growth-team/GROWTH-FY2015-ADC-VersionB/README.md

#GROWTH-FY2015-ADC-VersionB

Eagle PCB design files of GROWTH-FY2015 ADC Board Version B.

Parts library "Aardvark.lbr" is required to open the schematic and the board files with eagle.
