growth-team/GROWTH-FY2015-ADC-VersionB/P板.com/送り状.pdf

## 板 福島実装サービスセンター 担当：黒井 宛

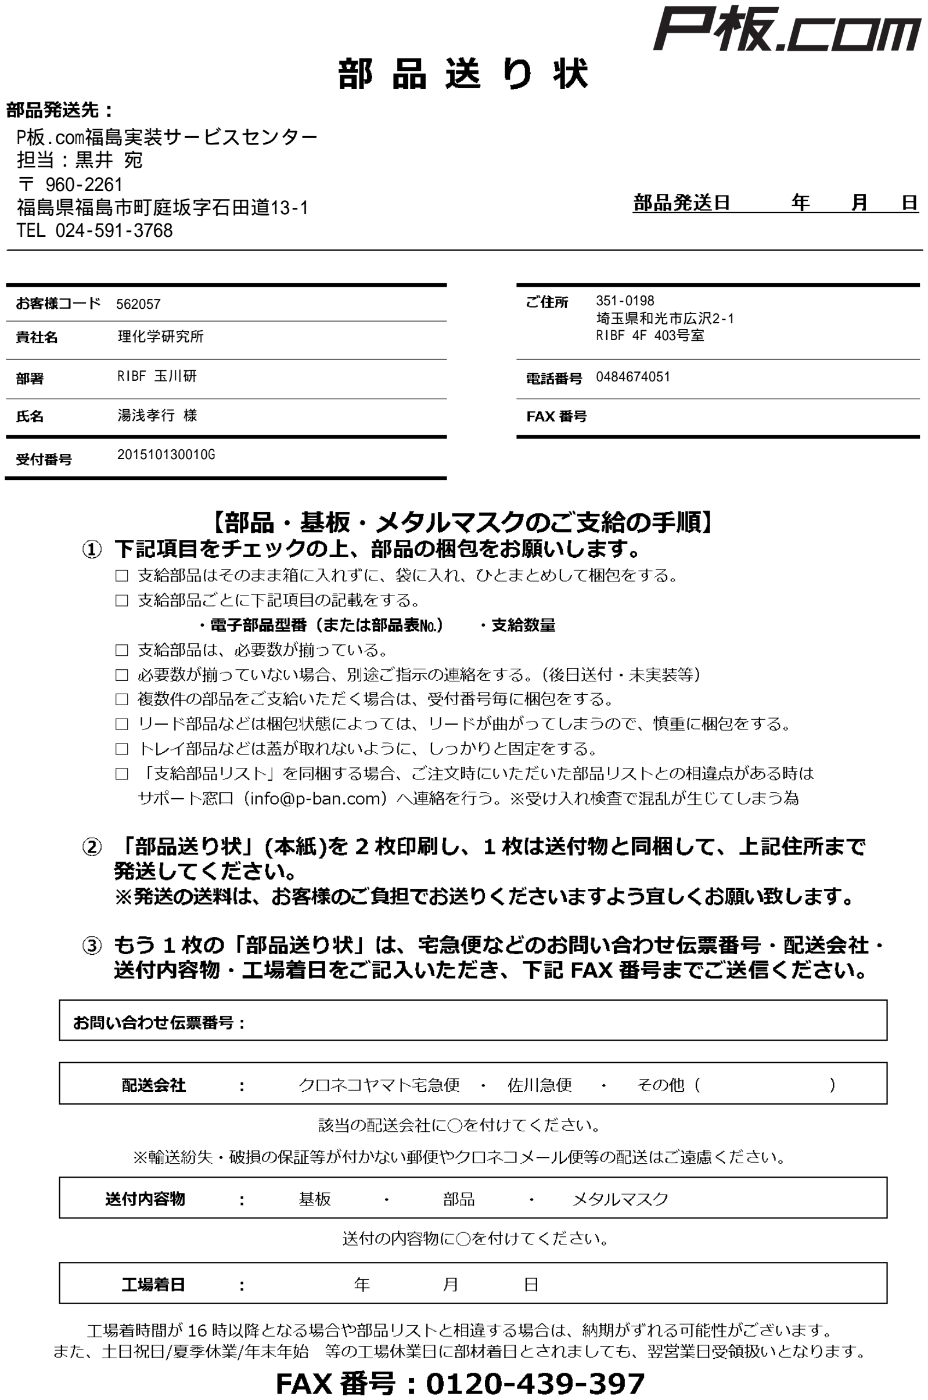
[picture p1: page 1]

〒

## 福島県福島市町庭坂字石田道 TEL 024-591-3768

351-0198 562057 | 埼玉県和光市広沢
理化学研究所 | 号室
玉川研 | 0484674051 湯浅孝行 様

201510130010G

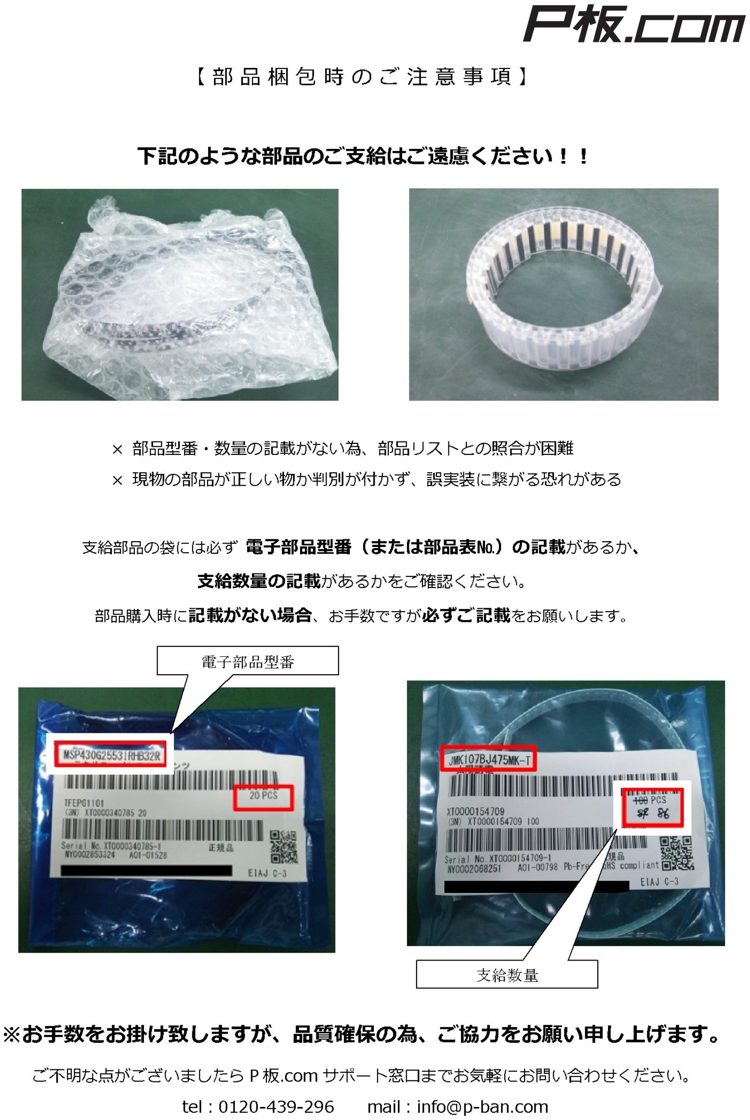
[picture p2: page 2]
