growth-team/GROWTH-FY2015-ADC-VersionB/P板.com/部品パーツリスト_2版.xls

Sheet: 必ずお読みください
入力項目説明
メ ー カ ー |  |  | 電子部品のメーカー名をご入力ください。
部 品 種 別 |  |  | 電子部品の種別をご入力ください。例：チップ抵抗、トランジスタ、LED、など
電 子 部 品 型 番 |  |  | 電子部品の型番をご入力ください。 ※誤表記による不具合を回避するためにも正確なご入力をお願い致します。 ※表面実装の抵抗やコンデンサ(電解、タンタル以外)は、後述「電子部品見取り表」をご参照のうえ、ご入力ください。
配 置 記 号 / リファレンス |  |  | シルク図/配置図に表記された配置記号/リファレンス番号をご入力ください。 ※複数入力する場合は、カンマ「,」区切りでのご入力をお願い致します。 ※電子部品型番ベースでのご記入をお願い致します。（１つの電子部品型番に対して、配置番号を複数記入）
個 数 |  |  | 電子部品の個数をご入力ください。
ピ ン 数 |  |  | 電子部品の総ピン数をご入力ください。 ※基板取付穴、部品取付穴、全てのスルー・ノンスルーホール、面実装部品のパッド、及び次の①～⑤の配線を伴う箇所（①テストピン、②チェックランド、③引き出しランド、④ジャンパピン、⑤入出力ランドの総計。
実装 / 未実装 |  |  | 実装サービスでの「実装」/「未実装」をご選択ください。 ※同じ電子部品型番の中で実装と未実装が分かれる場合は、それぞれ2行に分けて配置記号をご入力ください。
部品分類 | SMD |  | 表面実装部品
 | DIP |  | 挿入部品
 | 特殊 BGA等 |  | BGA/CSP/LGA/QFNなど部品極性が部品の真下に配置された部品 -BGA：Ball Grid Array/下面に半田ボールの端子を配置したパッケージ。 -CSP：Chip Size Package/チッププサイズと同じか、もしくは僅かに大きいパッケージ。 -LGA：Land Grid Array/裏面に外部入出力用のランドを設けたパッケージ。※BGAの半田ボールがない。 -QFN：Quad Flat Non-Lead Package/QFPに似ていますが、外部入出力用のピンが出ていないパッケージ。
P板.com提供部品 (無料) |  |  | P板.com実装サービスで無料提供しているチップ部品が含まれている場合に○をご選択ください。 ※無料提供部品：チップコンデンサ/チップ抵抗を約1500種、実装サービスをご利用のお客様に無料提供いたします。
 |  |  | http://www.p-ban.com/implementation/chip.html
P板.com調達部品(有料） |  |  | P板.com実装サービスで部品調達を希望される場合に○をご選択ください。 ※調達費用のお見積もりは、部品リストの返却と同時にご連絡いたします。 ※ご希望の納期や市場在庫状況によっては、調達が不可となる部品もございますので、予めご了承ください。
パッケージ情報 部品外形/部品仕様 |  |  | 電子部品のパッケージ情報をご入力ください。例：1608 , DIP , 0.5mmピッチQFP , 0.4mmピッチCN
コ メ ン ト |  |  | 特別なご指示のある電子部品について、自由にご入力ください。 例：未実装挿入穴のマスク処理が必要、など
版、変更履歴 |  |  | 部品種毎に、変更履歴を記載してください。 版は、アカウント登録の版に合わせて記載ください。
調達型式、代替型式 |  |  | 無料提供部品の在庫切れや、正確な調達型式を記載いたします。
部品名称見取り表
1.チップ部品（抵抗、コンデンサ）
 |  |  |  |  | 単位：ｍｍ
 |  |  | 電子部品型番 (C:コンデンサ、R:抵抗） | Ａ寸法 | Ｂ寸法
 |  |  | C/R1608 | 1.6 | 0.8
 |  |  | C/R2125 | 2 | 1.25
 |  |  | C/R3216 | 3.2 | 1.6
 |  |  | C/R3225 | 3.2 | 2.5
 |  |  | C/R4532 | 4.5 | 3.2
2.チップタンタルコンデンサ
 |  |  |  |  | 単位：ｍｍ
 |  |  | 電子部品型番 | Ａ寸法 | Ｂ寸法
 |  |  | CT3216 | 3.2 | 1.6
 |  |  | CT3528 | 3.5 | 2.8
 |  |  | CT4726 | 4.7 | 2.6
 |  |  | CT6032 | 6 | 3.2
 |  |  | CT5846 | 5.8 | 4.6
 |  |  | CT7343 | 7.3 | 4.3
3.チップアルミ電解コンデンサ
 |  |  |  |  |  | 単位：ｍｍ
 |  |  | 電子部品型番 | Ａ寸法 | Ｂ寸法 | C寸法
 |  |  | CE33 | 3.3 | 3.3 | φ3.0
 |  |  | CE43 | 4.3 | 4.3 | φ4.0
 |  |  | CE53 | 5.3 | 5.3 | φ5.0
 |  |  | CE66 | 6.6 | 6.6 | φ6.3
 |  |  | CE83 | 8.3 | 8.3 | φ8.0
 |  |  | CE103 | 10.3 | 10.3 | φ10.0
部品取り付け穴は、ピン数に含めてください。
コネクタの場合 |  |  |  |  |  | トランスの場合
部品リストフォーマット変更履歴
2014-02-01 | v2.0 | 松森 | 部品種別の総計を、直接関数に変更
 |  |  | ピン数合計、実装数合計数量を、直接関数に変更
 |  |  | 部品調達見積欄を修正
2014-03-11 | v2.1 | 松森 | *N列、O列が下の方、"○"選択リスト消えていたのを追加
 |  |  | *縮小しても解像度崩れず文字表示するため、フォントを"Meiryo UI"(Windows 標準添付)に変更
 |  |  | *136行目以降を非表示
 |  |  | *"X"列にリストを埋め込み
2014-06-12 | v2.2 | 松森 | *固定行を変更
 |  |  | *在庫状況列に条件付き書式設定
 |  |  | *その他各種バグ修正
2015-03-31 | V2.3 | 松森 | *無償提供部品を記載すると、無償提供部品欄に自動で"○"が表示されるよう条件式を挿入
 |  |  | *併せて、無償提供部品参照用一覧シートの作成・追加
 |  |  | *最小購入数が必要数量を下回る場合、セルを赤色にハッチングする
 |  |  | *シート1の名称変更
 |  |  | *変更履歴シートの追加
2015-06-19 | v2.4 | 松森 | ・ゼロΩ抵抗を無償対象に追加
 |  |  | ・変更履歴の列を追加し、変更履歴シートを削除
 |  |  | ・その他書式、印刷機能の変更
 |  |  | ・無償提供部品の入れ替え
2015-08-14 | v2.5 | 松森 | ・ゼロΩ抵抗の無償対象品が正しく反映されていなかったバグ修正
 |  |  | ・フォームへバージョン情報を埋め込み

Sheet: 部品リスト入力フォーム
Ver.2.5 |  |  | 電 子 部 品 型 番 ※半角英数字 ※サフィックスまで入力必須 | 配 置 記 号 リ フ ァ レ ン ス ※半角英数字） | 個数 | ピ ン 数 (部品取付穴 を含む） |  | 実装/ 未実装 | 部 品 分 類 |  |  | 必要数 実装枚数を入れてください。 ↓ | P板.com 提供 部品 (無料) | P板.com 調達 部品 (有料） | パッケージ情報 部品外形/部品仕様 | コ メ ン ト ※未実装挿入穴のマスク処理が必要、など | 版 変更履歴 | 調達型式、代替型式 |  | 入荷数 | 返却
No | メーカー | 部品種別 |  |  |  | 1個 あたり | 合計 | 実装個数 | SMD | DIP | 特殊 BGA等 |  |  |  |  |  |  | メーカー | 型名 |  |  | 部品調達使用欄
 |  |  |  |  | 170 | 342 | 749 | 170 | 132 | 38 | 0 | 4 | リスト (http://www.p-ban.com/implementation/chip.html)
例 | KOA | チップ抵抗 | RK73B2ATTD1002F | R1,R5,R9,R10 | 4 | 2 | 8 | 未実装 | SMD |  |  |  |  |  | 2012 |  | 4版 型式訂正、個数変更、実装→未実装へ |  |  |  |  | 必要数 | 調達数 | 在庫状況 | 納期
1 □ | 不明 | ピンヘッダ | 1x5ピンヘッダ | JP_SPI | 1 | 5 | 5 | 実装 | DIP | DIP | DIP | 4 | #N/A |  | DIP |  |  |  |  |  | □
2 □ | Lumberg | USB Type Aコネクタ | 2410 01 | J630, J640 | 2 | 6 | 12 | 実装 | DIP | DIP | DIP | 8 | #N/A |  | DIP |  |  |  |  |  | □
3 □ | TOSHIBA | P-ch MOSFET | 2SJ681 | U303, U521 | 2 | 3 | 6 | 実装 | DIP | DIP | DIP | 8 | #N/A |  | 2-7J2B |  |  |  |  |  | □
4 □ | 不明 | ピンソケット | 2x20 ピンソケット | J400 | 1 | 40 | 40 | 実装 | DIP | DIP | DIP | 4 | #N/A |  | DIP |  | 2版でコメント削除。 |  |  |  | □
5 □ | 不明 | ピンソケット | 2x20のピンソケット | J180_CN1, J180_CN2 | 2 | 40 | 80 | 実装 | DIP | DIP | DIP | 8 | #N/A |  | DIP |  |  |  |  |  | □
6 □ | 不明 | ピンヘッダ | 2x2ピンヘッダ | JP_ADC | 1 | 4 | 4 | 実装 | DIP | DIP | DIP | 4 | #N/A |  | DIP |  |  |  |  |  | □
7 □ | 不明 | ピンソケット | 2x7ピンソケット | JP_LCD | 1 | 14 | 14 | 実装 | DIP | DIP | DIP | 4 | #N/A |  | DIP |  |  |  |  |  | □
8 □ | Molex | USB mini Bコネクタ | 54819-0572 | J181, J182 | 2 | 9 | 18 | 実装 | SMD | SMD | SMD | 8 | #N/A |  | SMD |  |  |  |  |  | □
9 □ | Analog Devices | IC | AD8138AARZ | U101, U111, U121, U131 | 4 | 8 | 32 | 実装 | SMD | SMD | SMD | 16 | #N/A |  | SOIC-8 |  |  |  |  |  | □
10 □ | Analog Devices | IC | AD9215BRUZ-65 | U100, U110, U120, U130 | 4 | 28 | 112 | 実装 | SMD | SMD | SMD | 16 | #N/A |  | TSSOP-28 |  |  |  |  |  | □
11 □ | LEMO | 同軸コネクタ | EPL.00.250.NTN | J100, J110, J120, J130 | 4 | 5 | 20 | 実装 | DIP | DIP | DIP | 16 | #N/A |  | DIP |  |  |  |  |  | □
12 □ | Future Technology | IC | FT232RL | IC100 | 1 | 28 | 28 | 実装 | SMD | SMD | SMD | 4 | #N/A |  | SSOP28 |  |  |  |  |  | □
13 □ | Future Technology | IC | FT245RL | IC101 | 1 | 28 | 28 | 実装 | SMD | SMD | SMD | 4 | #N/A |  | SSOP28 |  |  |  |  |  | □
14 □ | MURATA | チップコンデンサ | GRM188B11H103K | C197 | 1 | 2 | 2 | 実装 | SMD | SMD | SMD | 4 | #NAME? |  | 1608 |  |  |  |  |  | □
15 □ | MURATA | チップコンデンサ | GRM2162C1H101J | C100, C110 | 2 | 2 | 4 | 実装 | SMD | SMD | SMD | 8 | #NAME? |  | 2012 |  |  |  |  |  | □
16 □ | MURATA | チップコンデンサ | GRM2162C1H201J | C101, C111 | 2 | 2 | 4 | 実装 | SMD | SMD | SMD | 8 | #NAME? |  | 2012 |  |  |  |  |  | □
17 □ | MURATA | チップコンデンサ | GRM219B11H333K | C102, C103, C112, C113 | 4 | 2 | 8 | 実装 | SMD | SMD | SMD | 16 | #NAME? |  | 2012 |  |  |  |  |  | □
18 □ | MURATA | チップコンデンサ | GRM21BB10J106K | C105, C109, C115, C119, C125, C129, C135, C139 | 8 | 2 | 16 | 実装 | SMD | SMD | SMD | 32 | #NAME? |  | 2012 |  |  |  |  |  | □
19 □ | MURATA | チップコンデンサ | GRM21BB11E104K | C104, C106, C107, C108, C114, C116, C117, C118, C124, C126, C127, C128, C134, C136, C137, C138, C190, C192, C193, C195 | 20 | 2 | 40 | 実装 | SMD | SMD | SMD | 80 | #NAME? |  | 2012 |  |  |  |  |  | □
20 □ | MURATA | チップコンデンサ | GRM21BB31E475K | C191, C194 | 2 | 2 | 4 | 実装 | SMD | SMD | SMD | 8 | #NAME? |  | 2012 |  |  |  |  |  | □
21 □ | MURATA | チップコンデンサ | GRM31CB11A106K | C198, C411, C601, C611, C620, C621, C623, C624 | 8 | 2 | 16 | 実装 | SMD | SMD | SMD | 32 | #NAME? |  | 3216 |  |  |  |  |  | □
22 □ | MURATA | チップコンデンサ | GRM31MB11C105K | C410, C622, C625 | 3 | 2 | 6 | 実装 | SMD | SMD | SMD | 12 | #NAME? |  | 3216 |  |  |  |  |  | □
23 □ | JAE | コネクタ | IL-G-2P-S3T2-SA | J121, J131, J620 | 3 | 2 | 6 | 実装 | DIP | DIP | DIP | 12 | #N/A |  | DIP |  |  |  |  |  | □
24 □ | JAE | コネクタ | IL-G-3P-S3T2-SA | J410, J411, J_UART | 3 | 3 | 9 | 実装 | DIP | DIP | DIP | 12 | #N/A |  | DIP |  |  |  |  |  | □
25 □ | JAE | コネクタ | IL-G-4P-S3T2-SA | J600_12V, J650_VOUT, J_I2C | 3 | 4 | 12 | 実装 | DIP | DIP | DIP | 12 | #N/A |  | DIP |  |  |  |  |  | □
26 □ | Fairchild Semiconductor | トランジスタ | KSP2222ABU | U302, U520 | 2 | 3 | 6 | 実装 | DIP | DIP | DIP | 8 | #N/A |  | TO-92 |  |  |  |  |  | □
27 □ | RSコンポーネンツ | DC電源ソケット | LD-0202-2.0 | J610 | 1 | 3 | 3 | 実装 | DIP | DIP | DIP | 4 | #N/A |  | DIP |  |  |  |  |  | □
28 □ | Texas Instruments | 温度センサ | LM60CIZ/NOPB | U413 | 1 | 3 | 3 | 実装 | DIP | DIP | DIP | 4 | #N/A |  | TO-92 |  |  |  |  |  | □
29 □ | Texas Instruments | IC | LM6172IM/NOPB | U102, U112 | 2 | 8 | 16 | 実装 | SMD | SMD | SMD | 8 | #N/A |  | SOP-8 |  |  |  |  |  | □
30 □ | Linear Technology | IC | LT6106HS5#TRMPBF | U500, U510 | 2 | 5 | 10 | 実装 | SMD | SMD | SMD | 8 | #N/A |  | TSOT-5 |  |  |  |  |  | □
31 □ | Linear Technology | IC | LTC1983ES6-3#TRMPBF | U620 | 1 | 6 | 6 | 実装 | SMD | SMD | SMD | 4 | #N/A |  | SMD |  |  |  |  |  | □
32 □ | Linear Technology | IC | LTC1983ES6-5#TRMPBF | U621 | 1 | 6 | 6 | 実装 | SMD | SMD | SMD | 4 | #N/A |  | SMD |  |  |  |  |  | □
33 □ | Vishay | 抵抗 | LVR03R0100FE12 | R500, R510 | 2 | 2 | 4 | 実装 | DIP | DIP | DIP | 8 | #N/A |  | DIP |  |  |  |  |  | □
34 □ | Microchip | IC | MCP1525T-I/TT | U411 | 1 | 3 | 3 | 実装 | SMD | SMD | SMD | 4 | #N/A |  | TSOT-23-3 |  |  |  |  |  | □
35 □ | Microchip | IC | MCP3208-CI/SL | U410 | 1 | 16 | 16 | 実装 | SMD | SMD | SMD | 4 | #N/A |  | SOIC-16 |  |  |  |  |  | □
36 □ | Texas Instruments | DCDC電源モジュール | PTH12050WAH | U600, U610 | 2 | 6 | 12 | 実装 | DIP | DIP | DIP | 8 | #N/A |  | DIP |  |  |  |  |  | □
37 □ | KOA | チップ抵抗 | RK73B2ATTD202J | R192, R610 | 2 | 2 | 4 | 実装 | SMD | SMD | SMD | 8 | #NAME? |  | 2012 |  |  |  |  |  | □
38 □ | KOA | チップ抵抗 | RK73B2ATTD302J | R190 | 1 | 2 | 2 | 実装 | SMD | SMD | SMD | 4 | #NAME? |  | 2012 |  |  |  |  |  | □
39 □ | KOA | チップ抵抗 | RK73B2ATTD473J | R300, R520 | 2 | 2 | 4 | 実装 | SMD | SMD | SMD | 8 | #NAME? |  | 2012 |  |  |  |  |  | □
40 □ | KOA | チップ抵抗 | RK73B2ATTD563J | R_PZC0, R_PZC1 | 2 | 2 | 4 | 実装 | SMD | SMD | SMD | 8 | #NAME? |  | 2012 |  |  |  |  |  | □
41 □ | KOA | チップ抵抗 | RK73H2ATTD1000F | R501, R511 | 2 | 2 | 4 | 実装 | SMD | SMD | SMD | 8 | #NAME? |  | 2012 |  |  |  |  |  | □
42 □ | KOA | チップ抵抗 | RK73H2ATTD1001F | R191, R193 | 2 | 2 | 4 | 実装 | SMD | SMD | SMD | 8 | #NAME? |  | 2012 |  |  |  |  |  | □
43 □ | KOA | チップ抵抗 | RK73H2ATTD1002F | R108, R118, R502, R512 | 4 | 2 | 8 | 実装 | SMD | SMD | SMD | 16 | #NAME? |  | 2012 |  |  |  |  |  | □
44 □ | KOA | チップ抵抗 | RK73H2ATTD1003F | R107, R117 | 2 | 2 | 4 | 実装 | SMD | SMD | SMD | 8 | #NAME? |  | 2012 |  |  |  |  |  | □
45 □ | KOA | チップ抵抗 | RK73H2ATTD1501F | R523, R601 | 2 | 2 | 4 | 実装 | SMD | SMD | SMD | 8 | #NAME? |  | 2012 |  |  |  |  |  | □
46 □ | KOA | チップ抵抗 | RK73H2ATTD2700F | R600 | 1 | 2 | 2 | 実装 | SMD | SMD | SMD | 4 | #NAME? |  | 2012 |  |  |  |  |  | □
47 □ | KOA | チップ抵抗 | RK73H2ATTD3300F | R197, R198 | 2 | 2 | 4 | 実装 | SMD | SMD | SMD | 8 | #NAME? |  | 2012 |  |  |  |  |  | □
48 □ | KOA | チップ抵抗 | RK73H2ATTD4701F | R301, R302, R303, R521, R522 | 5 | 2 | 10 | 実装 | SMD | SMD | SMD | 20 | #NAME? |  | 2012 |  |  |  |  |  | □
49 □ | KOA | チップ抵抗 | RK73H2ATTD5100F | R101, R102, R103, R104, R111, R112, R113, R114, R121, R122, R123, R124, R131, R132, R133, R134 | 16 | 2 | 32 | 実装 | SMD | SMD | SMD | 64 | #NAME? |  | 2012 |  |  |  |  |  | □
50 □ | KOA | チップ抵抗 | RK73H2ATTD51R0F | R100, R105, R106, R109, R110, R115, R116, R119, R120, R125, R126, R130, R135, R136 | 14 | 2 | 28 | 実装 | SMD | SMD | SMD | 56 | #NAME? |  | 2012 |  |  |  |  |  | □
51 □ | KOA | チップ抵抗 | RK73H2ATTD6800F | R400 | 1 | 2 | 2 | 実装 | SMD | SMD | SMD | 4 | #NAME? |  | 2012 |  |  |  |  |  | □
52 □ | ROHM | チップLED | SML-311WTT86 | LED_5V, LED_5V_SW, LED_HV, LED_RPI | 4 | 2 | 8 | 実装 | SMD | SMD | SMD | 16 | #N/A |  | 1608 |  |  |  |  |  | □
53 □ | Vishay | 可変抵抗 | T93YA502KT20 | VR100, VR110, VR300, VR301, VR_CONT | 5 | 2 | 10 | 実装 | DIP | DIP | DIP | 20 | #N/A |  | DIP |  |  |  |  |  | □
54 □ | Nichicon | 電解コンデンサ | UVR1V101MED | C600, C610 | 2 | 2 | 4 | 実装 | DIP | DIP | DIP | 8 | #N/A |  | DIP |  |  |  |  |  | □
55 □ |  |  |  |  |  |  |  |  |  |  |  |  |  |  |  |  |  |  |  |  | □
56 □ |  |  |  |  |  |  |  |  |  |  |  |  |  |  |  |  |  |  |  |  | □
57 □ |  |  |  |  |  |  |  |  |  |  |  |  |  |  |  |  |  |  |  |  | □
58 □ |  |  |  |  |  |  |  |  |  |  |  |  |  |  |  |  |  |  |  |  | □
59 □ |  |  |  |  |  |  |  |  |  |  |  |  |  |  |  |  |  |  |  |  | □
60 □ |  |  |  |  |  |  |  |  |  |  |  |  |  |  |  |  |  |  |  |  | □
61 □ |  |  |  |  |  |  |  |  |  |  |  |  |  |  |  |  |  |  |  |  | □
62 □ |  |  |  |  |  |  |  |  |  |  |  |  |  |  |  |  |  |  |  |  | □
63 □ |  |  |  |  |  |  |  |  |  |  |  |  |  |  |  |  |  |  |  |  | □
64 □ |  |  |  |  |  |  |  |  |  |  |  |  |  |  |  |  |  |  |  |  | □
65 □ |  |  |  |  |  |  |  |  |  |  |  |  |  |  |  |  |  |  |  |  | □
66 □ |  |  |  |  |  |  |  |  |  |  |  |  |  |  |  |  |  |  |  |  | □
67 □ |  |  |  |  |  |  |  |  |  |  |  |  |  |  |  |  |  |  |  |  | □
68 □ |  |  |  |  |  |  |  |  |  |  |  |  |  |  |  |  |  |  |  |  | □
69 □ |  |  |  |  |  |  |  |  |  |  |  |  |  |  |  |  |  |  |  |  | □
70 □ |  |  |  |  |  |  |  |  |  |  |  |  |  |  |  |  |  |  |  |  | □
71 □ |  |  |  |  |  |  |  |  |  |  |  |  |  |  |  |  |  |  |  |  | □
72 □ |  |  |  |  |  |  |  |  |  |  |  |  |  |  |  |  |  |  |  |  | □
73 □ |  |  |  |  |  |  |  |  |  |  |  |  |  |  |  |  |  |  |  |  | □
74 □ |  |  |  |  |  |  |  |  |  |  |  |  |  |  |  |  |  |  |  |  | □
75 □ |  |  |  |  |  |  |  |  |  |  |  |  |  |  |  |  |  |  |  |  | □
76 □ |  |  |  |  |  |  |  |  |  |  |  |  |  |  |  |  |  |  |  |  | □
77 □ |  |  |  |  |  |  |  |  |  |  |  |  |  |  |  |  |  |  |  |  | □
78 □ |  |  |  |  |  |  |  |  |  |  |  |  |  |  |  |  |  |  |  |  | □
79 □ |  |  |  |  |  |  |  |  |  |  |  |  |  |  |  |  |  |  |  |  | □
80 □ |  |  |  |  |  |  |  |  |  |  |  |  |  |  |  |  |  |  |  |  | □
81 □ |  |  |  |  |  |  |  |  |  |  |  |  |  |  |  |  |  |  |  |  | □
82 □ |  |  |  |  |  |  |  |  |  |  |  |  |  |  |  |  |  |  |  |  | □
83 □ |  |  |  |  |  |  |  |  |  |  |  |  |  |  |  |  |  |  |  |  | □
84 □ |  |  |  |  |  |  |  |  |  |  |  |  |  |  |  |  |  |  |  |  | □
85 □ |  |  |  |  |  |  |  |  |  |  |  |  |  |  |  |  |  |  |  |  | □
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
145 □ |  |  |  |  |  |  |  |  |  |  |  |  |  |  |  |  |  |  |  |  | □
146 □ |  |  |  |  |  |  |  |  |  |  |  |  |  |  |  |  |  |  |  |  | □
147 □ |  |  |  |  |  |  |  |  |  |  |  |  |  |  |  |  |  |  |  |  | □
148 □ |  |  |  |  |  |  |  |  |  |  |  |  |  |  |  |  |  |  |  |  | □

Sheet: 無償提供部品一覧
このシートの内容は変更しないでください。
メーカー型番 |  | メーカー | サイズ | 定数 | 許容差 | 定格
RK73Z1ETTP | ○ | KOA | 1005 | 0
RK73H1ETTP1R00F | ○ | KOA | 1005 | 1 | +/-1% | 0.063W
RK73B1ETTP1R0J | ○ | KOA | 1005 | 1 | +/-5% | 0.063W
RK73H1ETTP1R10F | ○ | KOA | 1005 | 1.1 | +/-1% | 0.063W
RK73B1ETTP1R1J | ○ | KOA | 1005 | 1.1 | +/-5% | 0.063W
RK73H1ETTP1R20F | ○ | KOA | 1005 | 1.2 | +/-1% | 0.063W
RK73B1ETTP1R2J | ○ | KOA | 1005 | 1.2 | +/-5% | 0.063W
RK73H1ETTP1R30F | ○ | KOA | 1005 | 1.3 | +/-1% | 0.063W
RK73B1ETTP1R3J | ○ | KOA | 1005 | 1.3 | +/-5% | 0.063W
RK73H1ETTP1R50F | ○ | KOA | 1005 | 1.5 | +/-1% | 0.063W
RK73B1ETTP1R5J | ○ | KOA | 1005 | 1.5 | +/-5% | 0.063W
RK73H1ETTP1R60F | ○ | KOA | 1005 | 1.6 | +/-1% | 0.063W
RK73B1ETTP1R6J | ○ | KOA | 1005 | 1.6 | +/-5% | 0.063W
RK73H1ETTP1R80F | ○ | KOA | 1005 | 1.8 | +/-1% | 0.063W
RK73B1ETTP1R8J | ○ | KOA | 1005 | 1.8 | +/-5% | 0.063W
RK73H1ETTP2R00F | ○ | KOA | 1005 | 2 | +/-1% | 0.063W
RK73B1ETTP2R0J | ○ | KOA | 1005 | 2 | +/-5% | 0.063W
RK73H1ETTP2R20F | ○ | KOA | 1005 | 2.2 | +/-1% | 0.063W
RK73B1ETTP2R2J | ○ | KOA | 1005 | 2.2 | +/-5% | 0.063W
RK73H1ETTP2R40F | ○ | KOA | 1005 | 2.4 | +/-1% | 0.063W
RK73B1ETTP2R4J | ○ | KOA | 1005 | 2.4 | +/-5% | 0.063W
RK73H1ETTP2R70F | ○ | KOA | 1005 | 2.7 | +/-1% | 0.063W
RK73B1ETTP2R7J | ○ | KOA | 1005 | 2.7 | +/-5% | 0.063W
RK73H1ETTP3R00F | ○ | KOA | 1005 | 3 | +/-1% | 0.063W
RK73B1ETTP3R0J | ○ | KOA | 1005 | 3 | +/-5% | 0.063W
RK73H1ETTP3R30F | ○ | KOA | 1005 | 3.3 | +/-1% | 0.063W
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
GRM188F11C154Z | ○ | MURATA | 1608 | 0.15uF | ＋80%, －20% | DC16V
GRM188B11A224K | ○ | MURATA | 1608 | 0.22uF | ±10% | DC10V
GRM188F11C224Z | ○ | MURATA | 1608 | 0.22uF | ＋80%, －20% | DC16V
GRM188B11A334K | ○ | MURATA | 1608 | 0.33uF | ±10% | DC10V
GRM188F11C334Z | ○ | MURATA | 1608 | 0.33uF | ＋80%, －20% | DC16V
GRM188B11A474K | ○ | MURATA | 1608 | 0.47uF | ±10% | DC10V
GRM188F11C474Z | ○ | MURATA | 1608 | 0.47uF | ＋80%, －20% | DC16V
GRM188F11A684Z | ○ | MURATA | 1608 | 0.68uF | ＋80%, －20% | DC10V
GRM188B11A105K | ○ | MURATA | 1608 | 1uF | ±10% | DC10V
GRM188F11A105Z | ○ | MURATA | 1608 | 1uF | ＋80%, －20% | DC10V
GRM188B31E105K | ○ | MURATA | 1608 | 1uF | ±10% | DC25V
GRM188B10J225K | ○ | MURATA | 1608 | 2.2uF | ±10% | DC6.3V
GRM2162C1H101J | ○ | MURATA | 2012 | 100pF | ±5% | DC50V
GRM2162C1H151J | ○ | MURATA | 2012 | 150pF | ±5% | DC50V
GRM2162C1H201J | ○ | MURATA | 2012 | 200pF | ±5% | DC50V
GRM2162C1H471J | ○ | MURATA | 2012 | 470pF | ±5% | DC50V
GRM2192C1H821J | ○ | MURATA | 2012 | 820pF | ±5% | DC50V
GRM2162C1H102J | ○ | MURATA | 2012 | 1000pF | ±5% | DC50V
GRM2162C1H222J | ○ | MURATA | 2012 | 2200pF | ±5% | DC50V
GRM2162B1H332K | ○ | MURATA | 2012 | 3300pF | ±10% | DC50V
GRM2162C1H332J | ○ | MURATA | 2012 | 3300pF | ±5% | DC50V
GRM219B11H333K | ○ | MURATA | 2012 | 0.033uF | ±10% | DC50V
GRM21BB11E104K | ○ | MURATA | 2012 | 0.1uF | ±10% | DC25V
GRM219F11H104Z | ○ | MURATA | 2012 | 0.1uF | ＋80%, －20% | DC50V
GRM2162F11E154Z | ○ | MURATA | 2012 | 0.15uF | ＋80%, －20% | DC25V
GRM21BF11E334Z | ○ | MURATA | 2012 | 0.33uF | ＋80%, －20% | DC25V
GRM219B11C474K | ○ | MURATA | 2012 | 0.47uF | ±10% | DC16V
GRM21BB11C105K | ○ | MURATA | 2012 | 1uF | ±10% | DC16V
GRM219F11C105Z | ○ | MURATA | 2012 | 1uF | ＋80%, －20% | DC16V
GRM21BB11A225K | ○ | MURATA | 2012 | 2.2uF | ±10% | DC10V
GRM21BB31E475K | ○ | MURATA | 2012 | 4.7uF | ±10% | DC25V
GRM21BB10J106K | ○ | MURATA | 2012 | 10uF | ±10% | DC6.3V
GRM21BB31A106K | ○ | MURATA | 2012 | 10uF | ±10% | DC10V
GRM21BB30J226M | ○ | MURATA | 2012 | 22uF | ±20% | DC6.3V
GRM319R11H104K | ○ | MURATA | 3216 | 0.1uF | ±10% | DC50V
GRM319B11H104K | ○ | MURATA | 3216 | 0.1uF | ±10% | DC50V
GRM319R72A104K | ○ | MURATA | 3216 | 0.1uF | ±10% | DC100V
GRM319R71H104K | ○ | MURATA | 3216 | 0.1uF | ±10% | DC50V
GRM319F11H104Z | ○ | MURATA | 3216 | 0.1uF | ＋80%, －20% | DC50V
GRM31MB11H224K | ○ | MURATA | 3216 | 0.22uF | ±10% | DC50V
GRM319B11C474K | ○ | MURATA | 3216 | 0.47uF | ±10% | DC16V
GRM31MB11C105K | ○ | MURATA | 3216 | 1uF | ±10% | DC16V
GRM31MB11E105K | ○ | MURATA | 3216 | 1uF | ±10% | DC25V
GRM31MB31H105K | ○ | MURATA | 3216 | 1uF | ±10% | DC50V
GRM31MF11E225Z | ○ | MURATA | 3216 | 2.2uF | ＋80%, －20% | DC25V
GRM31MB11C225K | ○ | MURATA | 3216 | 2.2uF | ±10% | DC16V
GRM31MF11C475Z | ○ | MURATA | 3216 | 4.7uF | ＋80%, －20% | DC16V
GRM31CB11A106K | ○ | MURATA | 3216 | 10uF | ±10% | DC10V
GRM31CF11E106Z | ○ | MURATA | 3216 | 10uF | ±10% | DC25V
GRM32RB11H105K | ○ | MURATA | 3225 | 1uF | ±10% | DC50V
GRM32NF11E106Z | ○ | MURATA | 3225 | 10uF | ＋80%, －20% | DC25V
GRM32EB11A106K | ○ | MURATA | 3225 | 10uF | ±10% | DC10V
