growth-team/GROWTH-FY2015-ADC-VersionB/部品調達/output_rs.ods

#部品種類 | メーカー型番 | メーカー | 個数 | 製造に 必要な数 | 理研 在庫数 | 要発注 | RS型番 | RS単価 | RS購入単位 | 1枚あたりの金額
電解コンデンサ | UVR1V101MED | Nichicon | 2 | 8 | 8 | 0 |  |  | 5 | 0
USB Type Aコネクタ | 2410 01 | Lumberg | 2 | 8 | 0 | 8 | 737-8782 | 109 | 1 | 218
トランジスタ | KSP2222ABU | Fairchild | 2 | 8 | 0 | 8 | 739-0385 | 27.4 | 10 | 54.8
P-ch MOSFET | 2SJ681 | TOSHIBA | 2 | 8 | 0 | 8 | 362-812 | 165.0 | 5 | 330
USB mini Bコネクタ | 54819-0572 | Molex | 2 | 8 | 4 | 4 | 515-1995 | 124.0 | 5 | 248
IC | AD8138AARZ | Analog Devices | 4 | 16 | 2 | 14 | 820-8990 | 600.0 | 2 | 2400
IC | AD9215BRUZ-65 | Analog Devices | 4 | 16 | 0 | 16 | 538-6371 | 1461.0 | 1 | 5844
同軸コネクタ | EPL.00.250.NTN | LEMO | 4 | 16 | 8 | 8 | 124-8635 | 2260.0 | 1 | 9040
IC | FT232RL | Future Technology | 1 | 4 | 0 | 4 | 888-8732 | 397.0 | 1 | 397
IC | FT245RL | Future Technology | 1 | 4 | 0 | 4 | 406-540 | 508.0 | 1 | 508
コネクタ | IL-G-2P-S3T2-SA | JAE | 5 | 20 | 4 | 16 | 490-6508 | 30.0 |  | 150
コネクタ | IL-G-3P-S3T2-SA | JAE | 3 | 12 | 0 | 12 | 490-6514 | 30.0 |  | 90
コネクタ | IL-G-4P-S3T2-SA | JAE | 3 | 12 | 12 | 0 | 490-6520 | 30.0 |  | 90
DC電源ソケット | LD-0202-2.0 | RSコンポーネンツ | 1 | 4 | 4 | 0 | 448-382 | 77.0 | 10 | 77
温度センサ | LM60CIZ/NOPB | Texas Instruments | 2 | 8 | 3 | 5 | 761-6003 | 92.8 | 5 | 185.6
IC | LM6172IM/NOPB | Texas Instruments | 2 | 8 | 0 | 8 | 534-3627 | 500.0 | 1 | 1000
IC | LT6106HS5#TRMPBF | Linear Technology | 2 | 8 | 3 | 5 | 786-9727 | 378.2 | 5 | 756.4
IC | LTC1983ES6-3#TRMPBF | Linear Technology | 1 | 4 | 0 | 4 | 858-0876 | 368.5 | 2 | 368.5
IC | LTC1983ES6-5#TRMPBF | Linear Technology | 1 | 4 | 0 | 4 | 761-9276 | 709.0 | 1 | 709
抵抗 | LVR03R0100FE12 | Vishay | 2 | 8 | 6 | 2 | 683-6212 | 107.0 | 5 | 214
IC | MCP1525T-I/TT | Microchip | 1 | 4 | 0 | 4 | 698-9069 | 121.0 | 1 | 121
IC | MCP3208-CI/SL | Microchip | 1 | 4 | 4 | 0 | 379-2522 | 550.0 | 5 | 550
DCDC電源モジュール | PTH12050WAH | Texas Instruments | 2 | 8 | 0 | 8 | 660-6392 | 1784.0 | 1 | 3568
チップLED | SML-311WTT86 | ROHM | 4 | 16 | 0 | 16 | 752-6789 | 11.5 | 10 | 46
可変抵抗 | T93YA502KT20 | Vishay | 5 | 20 | 5 | 15 | 788-5079 | 182.0 | 5 | 910
GPSモジュール | FGPMMOPA6H | GlobalTop | 1 | 4 | 2 | 2 |  | 3500.0 |  | 3500
ピンヘッダ | 1x5ピンヘッダ | 不明 | 1 | 4 | 0 | 4 | 681-2985 | 33.0 | 10 | 33
ピンヘッダ | 2x20 ピンヘッダ | 不明 | 1 | 4 | 4 | 0 |  | 50.0 |  | 50
ピンヘッダ | 2x2ピンヘッダ | 不明 | 2 | 8 | 0 | 8 | 767-0820 | 52.0 | 1 | 104
ピンヘッダ | 2x20のピンヘッダ | 不明 | 2 | 8 | 3 | 5 |  | 50.00 |  | 100
 |  |  |  |  |  |  |  |  | 合計 | 31662.3
 |  | 製造枚数 | 4
 |  | 2x20ピンソケット |  | 12
 |  |  |  |  | 316-6232 | 0
 |  |  |  |  | 737-8782 | 8
 |  |  |  |  | 806-4471 | 8
 |  |  |  |  | 362-812 | 8
 |  |  |  |  | 515-1995 | 4
 |  |  |  |  | 820-8990 | 14
 |  |  |  |  | 538-6371 | 16
 |  |  |  |  | 124-8635 | 8
 |  |  |  |  | 888-8732 | 4
 |  |  |  |  | 406-540 | 4
 |  |  |  |  | 490-6508 | 16
 |  |  |  |  | 490-6514 | 12
 |  |  |  |  | 490-6520 | 0
 |  |  |  |  | 448-382 | 0
 |  |  |  |  | 761-6003 | 5
 |  |  |  |  | 534-3627 | 8
 |  |  |  |  | 786-9727 | 5
 |  |  |  |  | 858-0876 | 4
 |  |  |  |  | 761-9276 | 4
 |  |  |  |  | 683-6212 | 2
 |  |  |  |  | 698-9069 | 4
 |  |  |  |  | 379-2522 | 0
 |  |  |  |  | 660-6392 | 8
 |  |  |  |  | 752-6789 | 16
 |  |  |  |  | 788-5079 | 15
 |  |  |  |  | 681-2985 | 4
 |  |  |  |  | 767-0820 | 8
 |  |  |  |  |  | 5
