growth-team/GROWTH-FY2015-ADC-VersionB/P板.com/配置図_20151014_1310.pdf

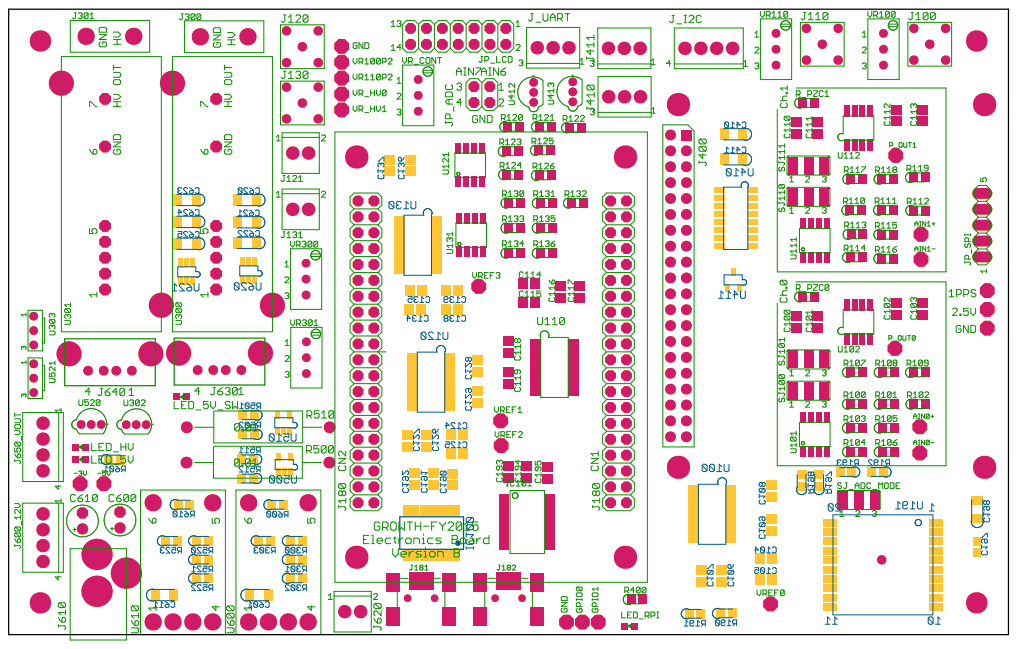
[picture p3: page 1]
