growth-team/GROWTH-FY2015-ADC-VersionB/P板.com/配置図_20151013_1930.pdf

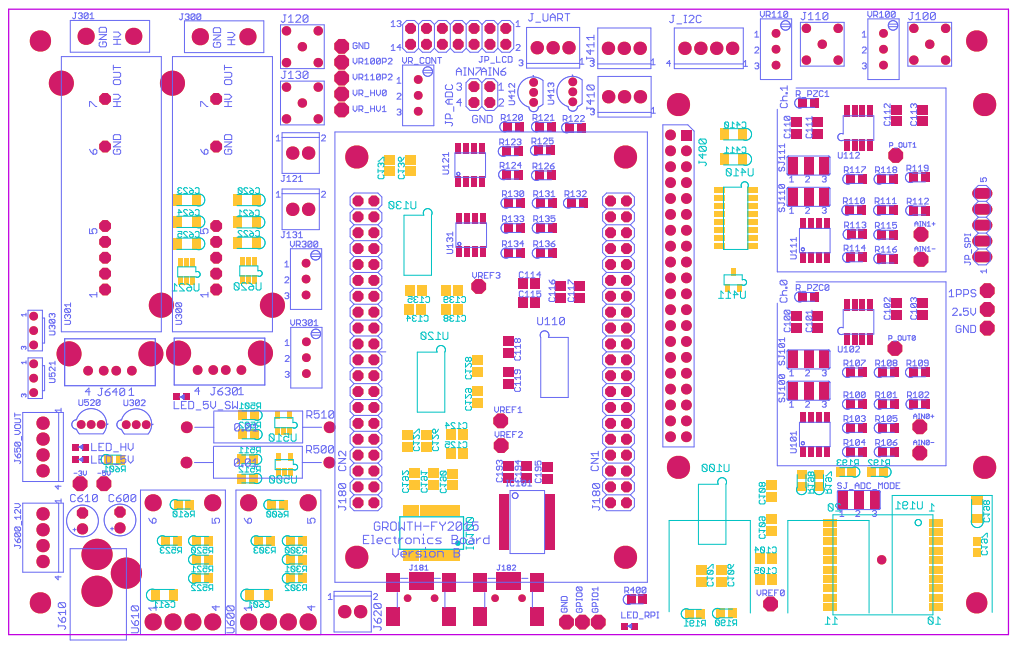
[picture p4: page 1]
