growth-team/GROWTH-FY2015-ADC-VersionB/ExtBoard.brd

## EAGLE design ExtBoard.brd (2015-10-21)

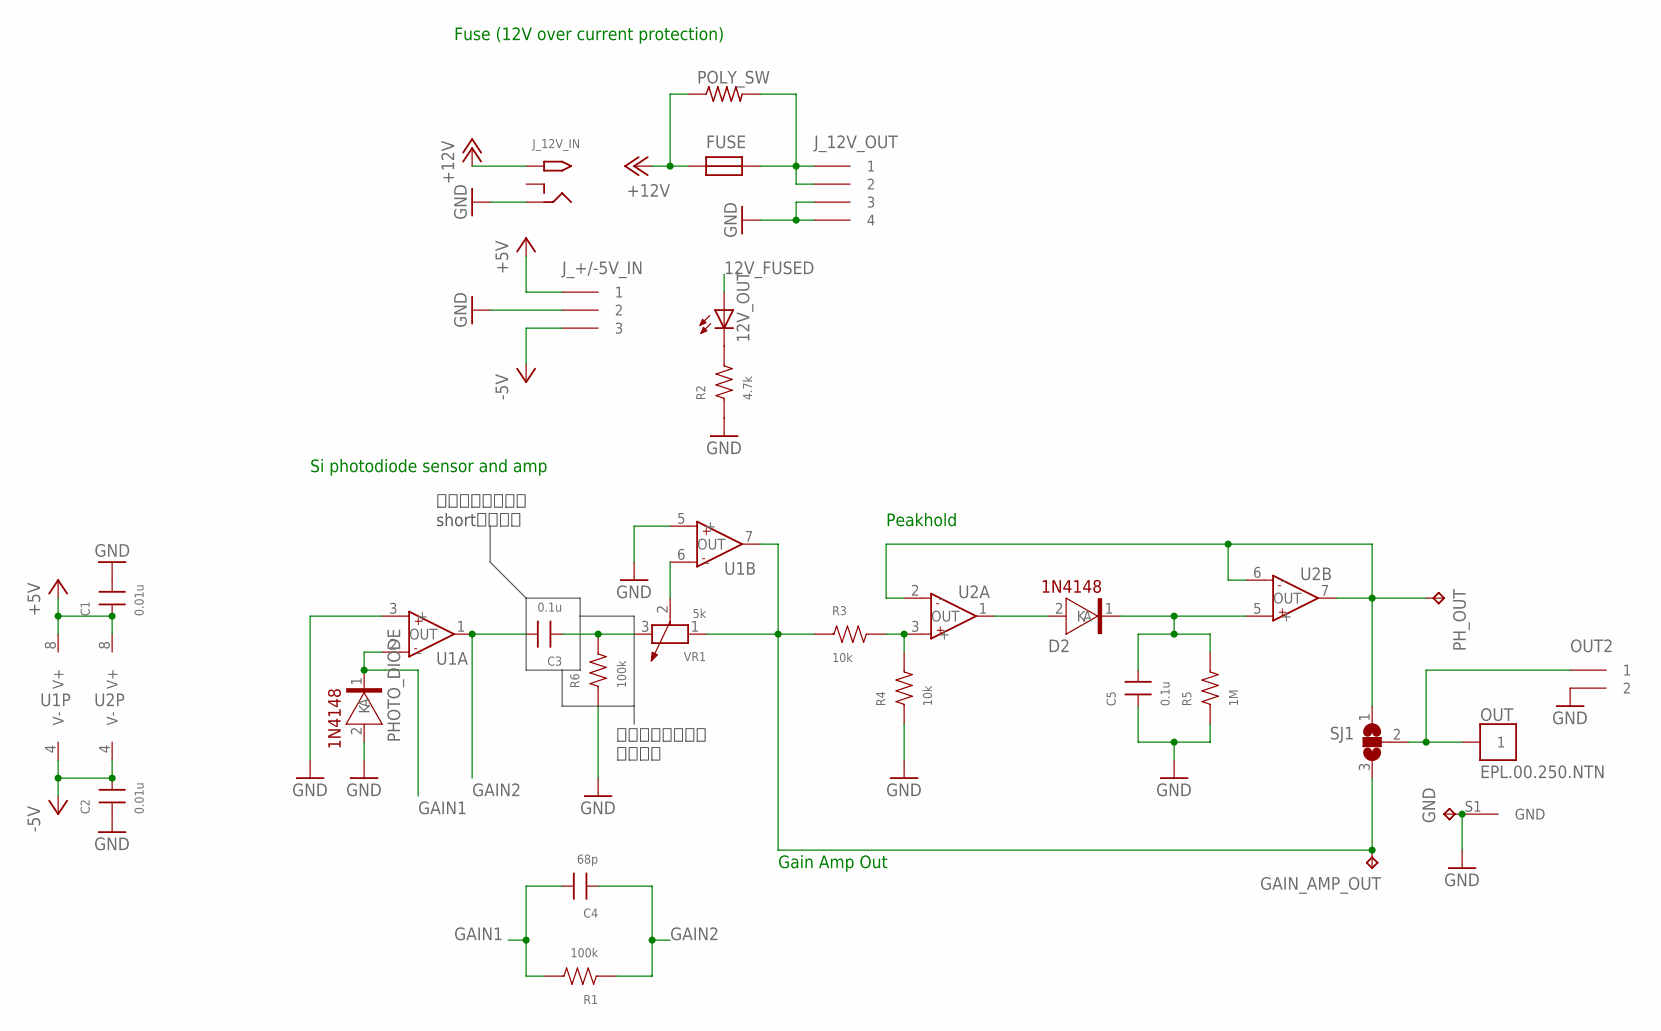
[picture p5: schematic ExtBoard.sch]

Parts:
12V_OUT: LED_1608
C1, C2: 0.01u; 3216
C3, C5: 0.1u; 3216
C4: 68p; 3216
D2: 1N4148; 4020-2P
FUSE: FUSE_LITTLEFUSE_649; LITTLEFUSE_649
GAIN_AMP_OUT: TPPAD1-13; P1-13
GND: TPPAD1-13; P1-13
J_12V_IN: 2.1MMJACKTHM; PJ-102A
J_12V_OUT: IL-4P-S3EN2
J_+/-5V_IN: IL-3P-S3EN2
OUT: EPL.00.250.NTN
OUT2: IL-2P-S3EN2
PHOTO_DIODE: 1N4148; 4020-2P
PH_OUT: TPPAD1-13; P1-13
POLY_SW: R-US_0207/10; 0207/10
R1, R6: 100k; 2012
R2: 4.7k; 2012
R3, R4: 10k; 2012
R5: 1M; 2012
SJ1: SJ2WW; SJ_2W
U1, U2: LM6172SOIC(D)8; SOP8
VR1: 5k; ADJRP3-9.70XW5.0X9.80MM

Connections:
12V_FUSED: 12V_OUT.P$1 (A), FUSE.P$2, J_12V_OUT.P$1 (1), J_12V_OUT.P$2 (2), POLY_SW.2
+5V: C1.1, J_+/-5V_IN.P$1 (1), U1.8 (V+), U2.8 (V+)
+12V: FUSE.P$1, J_12V_IN.TIP, POLY_SW.1
-5V: C2.2, J_+/-5V_IN.P$3 (3), U1.4 (V-), U2.4 (V-)
GAIN1: C4.2, PHOTO_DIODE.1 (K), R1.2, U1.2 (-)
GAIN2: C3.2, C4.1, R1.1, U1.1 (OUT)
GAIN_AMP_OUT: GAIN_AMP_OUT.TP, R3.1, SJ1.3, U1.7 (OUT), VR1.1
GND: C1.2, C2.1, C5.1, GND.TP, J_12V_IN.RING, J_12V_OUT.P$3 (3), J_12V_OUT.P$4 (4), J_+/-5V_IN.P$2 (2), OUT.S1 (GND), OUT2.P$2 (2), PHOTO_DIODE.2 (A), R2.1, R4.1, R5.1, R6.1, U1.3 (+), U1.5 (+)
unnamed: OUT.1, OUT2.P$1 (1), SJ1.2
unnamed: U1.6 (-), VR1.2
unnamed: C5.2, D2.1 (K), R5.2, U2.5 (+)
unnamed: R3.2, R4.2, U2.3 (+)
unnamed: D2.2 (A), U2.1 (OUT)
unnamed: C3.1, R6.2, VR1.3
unnamed: 12V_OUT.P$2 (C), R2.2
PH_OUT: PH_OUT.TP, SJ1.1, U2.2 (-), U2.6 (-), U2.7 (OUT)

Notes on the sheet:
Fuse (12V over current protection)
Si photodiode sensor and amp
Peakhold
微分しない場合は shortさせる。
Gain Amp Out
微分しない場合は 未実装。

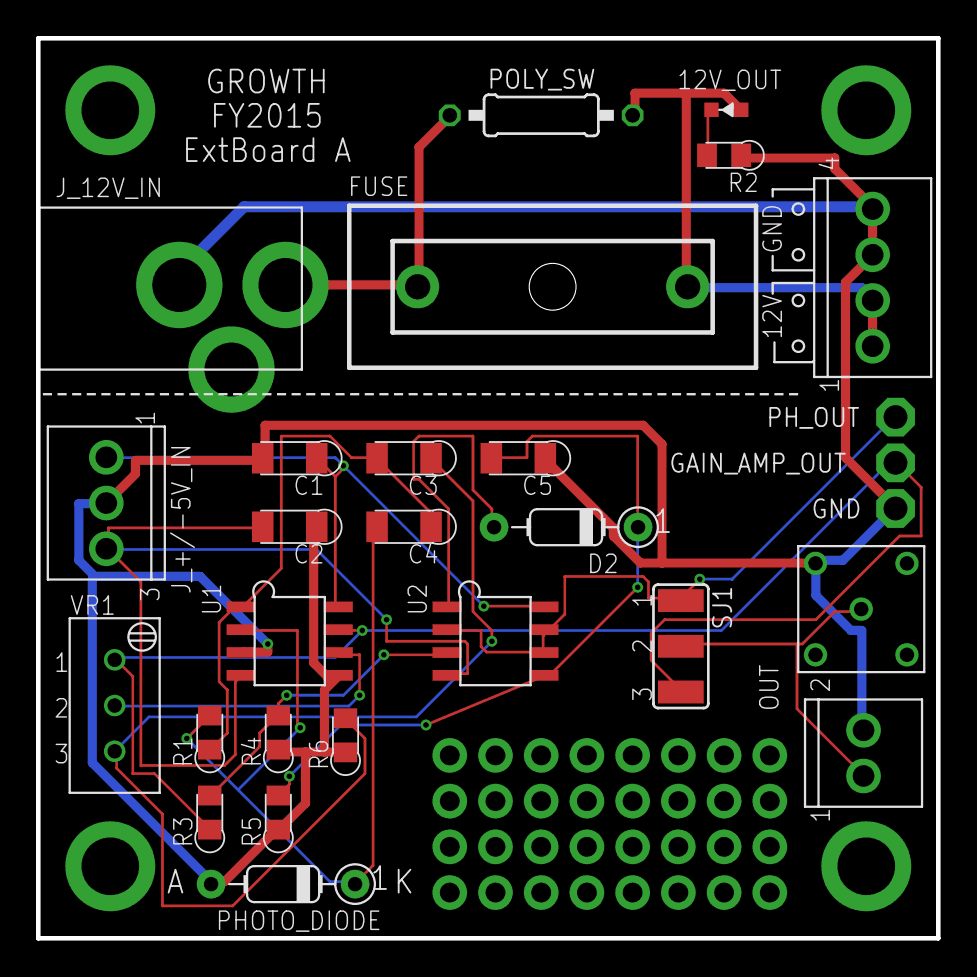
[picture p6: board ExtBoard.brd from above]

Board: 2 copper layers, 50.0 x 50.0 mm, 29 parts (1 on the bottom side), 16 nets.

Other parts of the board:
E$1: AARDVARK_LOGO
