growth-team/GROWTH-FY2015-ADC-VersionB/(commit log)

2015-05-14 first commit on 20150514_1112
    [G_FY2015_Mez.sch]
2015-05-14 G_FY2015_Mez.sch - completed first drafting
    [G_FY2015_Mez.sch]
2015-05-14 G_FY2015_Mez.brd - partially placed
    [G_FY2015_Mez.brd, G_FY2015_Mez.sch]
2015-05-18 first board layout completed
    [G_FY2015_Mez.brd, G_FY2015_Mez.sch]
2015-05-18 board layout completed, 100% routerd, logo inserted
    [G_FY2015_Mez.brd, G_FY2015_Mez.sch]
2015-05-18 GNDA and AGND removed (just use GND)
    [G_FY2015_Mez.brd, G_FY2015_Mez.sch]
2015-05-18 GND plane introduced to top/bottom
    [G_FY2015_Mez.brd, G_FY2015_Mez.sch]
2015-05-19 G_FY2015_Mez.brd - GROWTH logo added to the board
    [G_FY2015_Mez.brd]
2015-05-19 +5V_BEFORE_SENSE and +3V3_BEFORE_SENSE properly connected (previously they were not connected)
    [G_FY2015_Mez.brd, G_FY2015_Mez.sch]
2015-05-19 power connection manually routed in the board design
    [G_FY2015_Mez.brd, G_FY2015_Mez.sch]
2015-05-19 routing modified (GND plane not introduced)
    [G_FY2015_Mez.brd]
2015-05-28 P-ban.com submitted version
    [G_FY2015_Mez.brd]
2015-09-04 version 20150904 (placement completed; before replacing with complementray SMD resistor and cap)
    [G_FY2015_Mez.brd, G_FY2015_Mez.sch]
2015-09-11 as of 20150911 (4ch, FT232RL) before adding FT245 for higher data transfer rate
    [G_FY2015_Mez.brd, G_FY2015_Mez.sch]
2015-10-13 version B completed. before autoroute for P-ban submit
    [G_FY2015_Mez.brd, G_FY2015_Mez.sch]
2015-10-13 Ch.0 and Ch.1 connector modified, slow ADC and Ras Pi locations modified
    [G_FY2015_Mez.brd, G_FY2015_Mez.sch]
2015-10-13 VR_CONT location modified
    [G_FY2015_Mez.brd]
2015-10-13 LM60 (near DCDC) moved. Hand wiring necessary while integration
    [G_FY2015_Mez.brd]
2015-10-13 P板.comに注文した時のバージョン
    [G_FY2015_Mez.brd, output.csv, output_rs.csv, output_rs.ods, 部品パーツリスト.xls]
2015-10-14 netclass "power" added, and supply/gnd signals changed to "power" net
    [G_FY2015_Mez.brd, G_FY2015_Mez.sch]
2015-10-14 routed for 2nd submit (supply/gnd have thicker connections)
    [G_FY2015_Mez.brd]
2015-10-14 Raspberry Pi tPlace => bDocument (update for 2nd submit to p-ban.com)
    [G_FY2015_Mez.brd, G_FY2015_Mez.sch]
2015-10-14 2nd submit to p-ban.com
    - solder stop masks
    - Raspberry Pi 2 tPlace => bDocu
    - thickness of supply/gnd connections
2015-10-14 parts list version 2 (following comments from p-ban.com)
    [部品パーツリスト_2版.xls]
2015-10-21 ExtBoard (fuse + si photo-diode amp) added. ExtBoard_Gerber_20151021_0010 submitted to Elecrow.
    [ExtBoard.GBL, ExtBoard.GBO, ExtBoard.GBP, ExtBoard.GBS, ExtBoard.GTL, ExtBoard.GTO, ExtBoard.GTP, ExtBoard.GTS]
